jeffmc6767/Autonomous-drone/README.md

JFC,
-
My custom 20x20 drone FC stack for 4s setups, and my custom 3 inch drone frame. 

Screenshot 2026-08-27 at 12 05 02 PM
Screenshot 2026-10-15 at 9 36 35 PM

**FOR THE STARDANCE REVIEWS:** I submitted this a long time ago I dont remember if I said in the note. In my KICAD schematic the wiring is all on the LEFT side. Just zoom out and you can see everything.
Specs:
- 

- up to 99km/h (I calculated based on other drones with similar setup and weight)
- A theoretical 5-7 minutes of flight time though im not sure 
- Costs around 1.2$ a print and tees 3.5 hours. 
- 4K video 60fps (from the dji o4 air unit)
- Usable with Ardu pilot, betafpv, and most other open source software, though I coded one myself(and with the help of AI). Its under the Firmware file
- 44g PLA and PETG print. 

Build guide:
-

Here's how you can start building this yourself:

1. Produce the PCB(like from a pcb manufacturer)
2. Buy all components from the BOM.CSV.
3. Solder all of the components on the PCB(I would recoment using the PCB file because I deleted a lot of the silkscreen text so it would be easier to design)
4. Follow the instructions in the 'Firmware Readme.md' (In the firmware file)
5. Print the drone frame(More about it below)
6. Install the ESC, motors, and solder the connections.
7. Install the FC and solder those connections and connect the ESC to the FC.
8. Install the DJI o4 air unit and also solder or connect the pins and headers. Mount the camera and antennas.
9. If you prefer ELRS you can install that too. I have included the pins. TX, RX, 5.5V, GND
10. Pair with your DJI Goggles and ELRS or DJI controller
11. FLYYY!!

**About the drone frame:**
I have included 3 step files:
1. 1x Top Plate - Top cover for the frame
2. 1x Bottom Plate - The bottom plate
3. 2x TPU Guards - Protects the propellers and motors

Images gallery:
-

Current Version: 
-
**V5.5:** New Drone frame I designed myself: 

It's a 3 inch drone frame that I designed for 1506 motors. It can support a 20x20mm stack and 25.4x25.4 dji o4 air unit. 

It has 4 rubber/tpu things that go around the bottom of the props to protect it. 

In total, it weighs 44g when 3d printed. 
Screenshot 2026-10-15 at 9 28 00 PM

**V5:**
PCB layout:  
The main changes I made was the dimensions from 39mmx37mm to 30mmx32mm. Everything is now compacted and looks much better from the V3 where it was larger and stuff was everywhere. I improved the routing of all of the components and moved every single component to the top of the board that I can use a hot plate and solder everything at once more easily and efficiently. 

- Added ELRS pads for communication
- Added GPS RX and TX
- Added Borometer pads
- Coded the firmware
Screenshot 2026-08-27 at 12 05 02 PM
Screenshot 2026-08-27 at 12 07 03 PM

Screenshot 2026-08-27 at 12 09 32 PM

**Past Versions:**
V4:
-

transferred all B.CU components to the F.CU (not the JST connector) and modified the Edge.cuts 
Screenshot 2026-08-21 at 5 43 20 PM
Screenshot 2026-08-22 at 11 22 32 PM

Screenshot 2026-08-22 at 11 22 59 PM
Screenshot 2026-08-22 at 11 23 20 PM

V3:
-
Screenshot 2026-08-17 at 3 55 34 PM

V2:
-
Screenshot 2026-07-31 at 7 13 25 PM
Screenshot 2026-07-31 at 7 15 06 PM

V1:
- 
Screenshot 2026-07-30 at 10 27 04 PM
