jeffmc6767/Autonomous-drone/CAD/FULL CAD ASSEMBLY.step

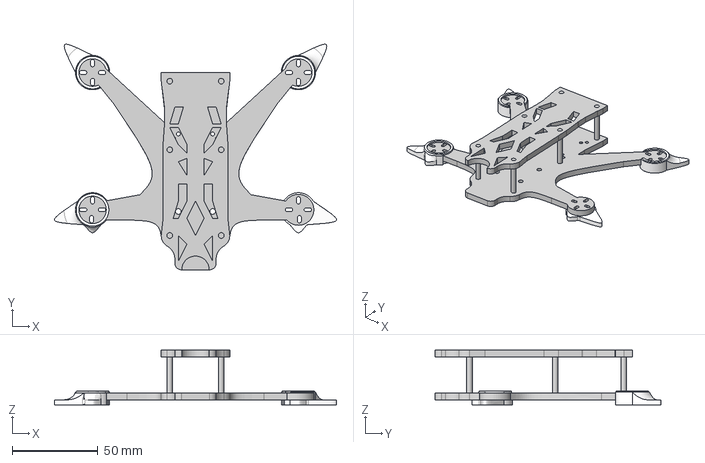
[picture p1: CAD file, 2026-10-16]
CAD/FULL CAD ASSEMBLY.step
164.4 x 131.5 x 32.0 mm
