jeffmc6767/Autonomous-drone/CAD/past versions/Autonomous drone v1.stl

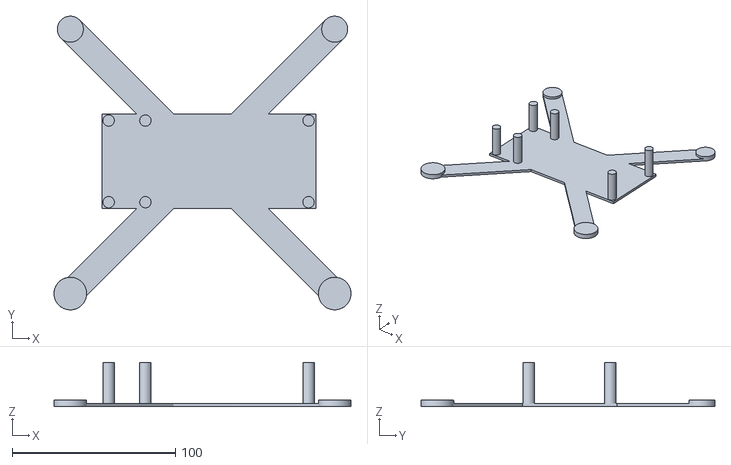
[picture p2: CAD file, 2026-08-21]
CAD/past versions/Autonomous drone v1.stl
182.0 x 180.0 x 27.0
