jeffmc6767/Autonomous-drone/PCB/Schematics and symbols/16-pin-smd-usb-c-connector-through-holes-1/usb-c_16pins_vertical.step

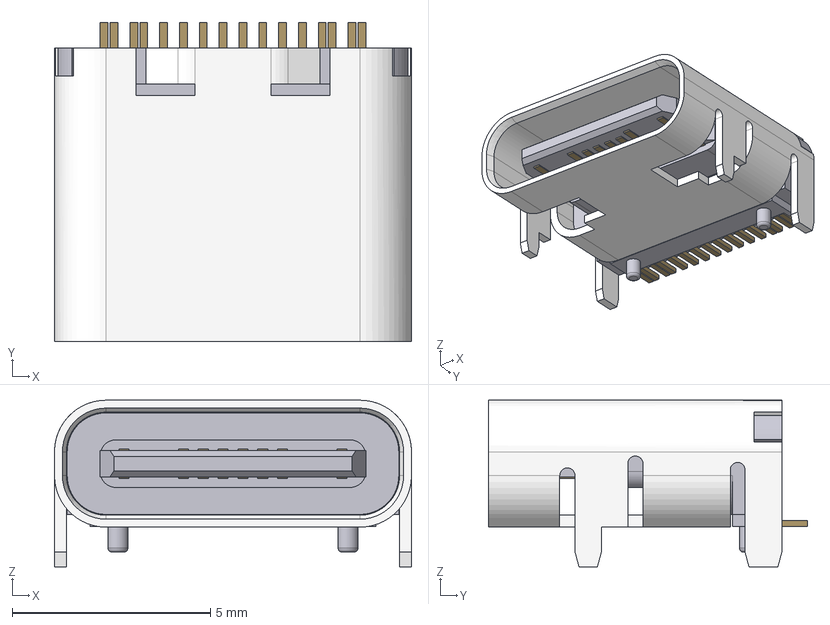
[picture p3: CAD file, 2026-08-21]
PCB/Schematics and symbols/16-pin-smd-usb-c-connector-through-holes-1/usb-c_16pins_vertical.step
9.00 x 8.05 x 4.20 mm
tongue
shield
contact_001
contact_002
contact_003
contact_004
contact_court_001
contact_court_002
contact_court_003
contact_court_004
contact_005
contact_006
contact_007
contact_008
contact_court_005
contact_court_006
contact_court_007
contact_court_008
pin_001
pin_002
pin_003
pin_004
pin_005
pin_006
pin_007
pin_008
pin_009
pin_010
pin_011
pin_012
pin_013
pin_014
pin_015
pin_016
