jeffmc6767/Autonomous-drone/PCB/Schematics and symbols/AON7804/3D/AON7804.stp

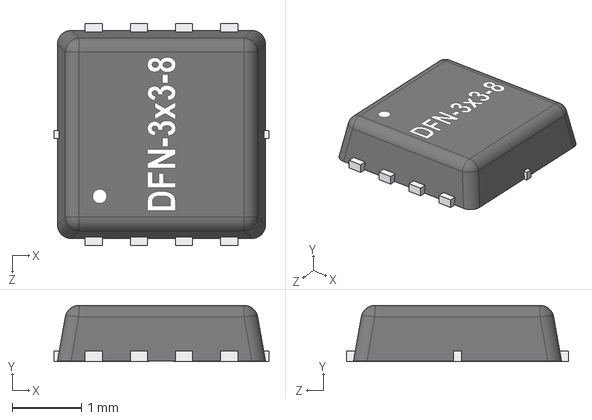
[picture p4: CAD file, 2026-08-21]
PCB/Schematics and symbols/AON7804/3D/AON7804.stp
3.10 x 0.81 x 3.20 mm
lead frame
