jeffmc6767/Autonomous-drone/PCB/Schematics and symbols/LIB_AON7544/AON7544/3D/AON7544.stp

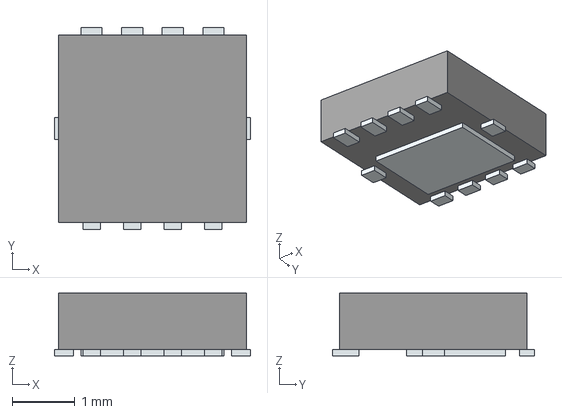
[picture p5: CAD file, 2026-08-21]
PCB/Schematics and symbols/LIB_AON7544/AON7544/3D/AON7544.stp
3.13 x 3.24 x 1.00 mm
Pins
