jeffmc6767/Autonomous-drone/PCB/Schematics and symbols/LIB_AP2127K-3/AP2127K-3.3TRG1/3D/AP2127K-3.3TRG1.stp

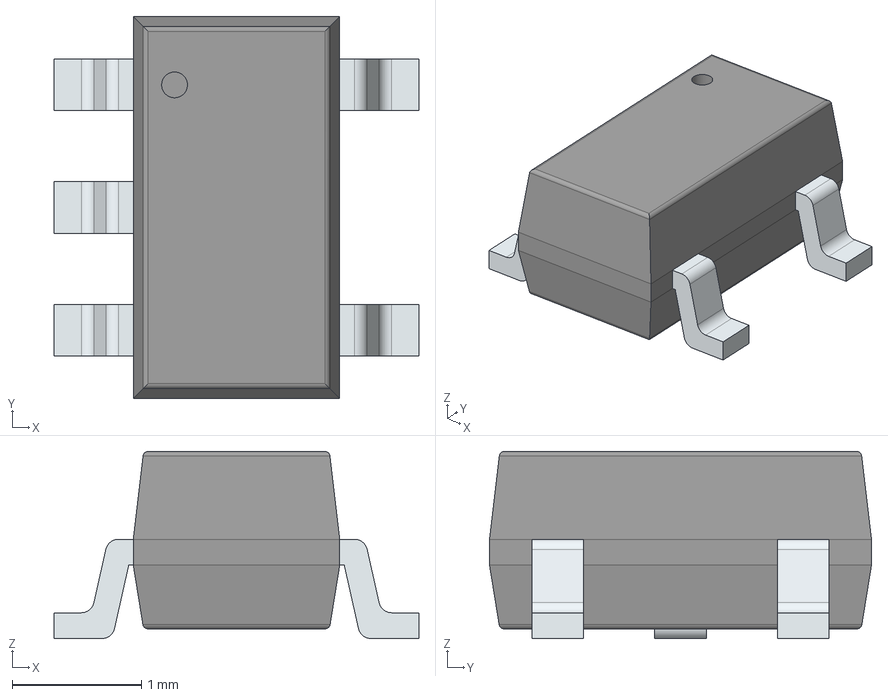
[picture p6: CAD file, 2026-08-21]
PCB/Schematics and symbols/LIB_AP2127K-3/AP2127K-3.3TRG1/3D/AP2127K-3.3TRG1.stp
2.83 x 2.96 x 1.45 mm
PinsArrayL
PinsArrayR
