jeffmc6767/Autonomous-drone/PCB/Schematics and symbols/LIB_BMI270-2/BMI270/3D/BMI270.stp

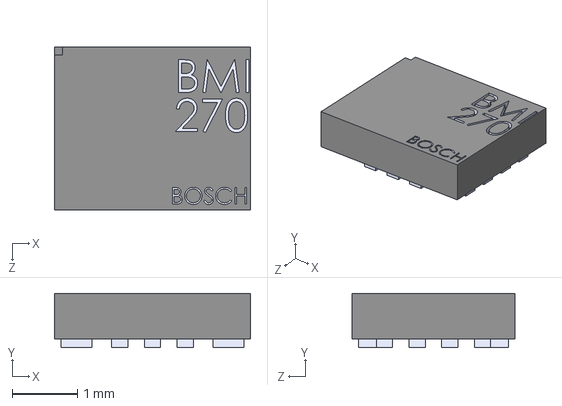
[picture p7: CAD file, 2026-08-21]
PCB/Schematics and symbols/LIB_BMI270-2/BMI270/3D/BMI270.stp
3.00 x 0.83 x 2.50 mm
