jeffmc6767/Autonomous-drone/PCB/Schematics and symbols/LIB_bmp280/bmp280/3D/bmp280.stp

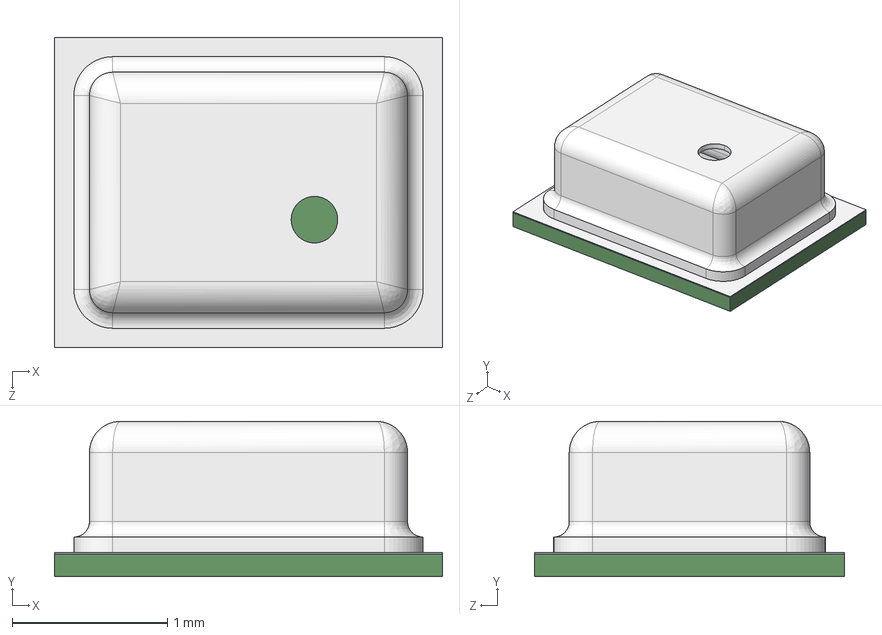
[picture p8: CAD file, 2026-08-21]
PCB/Schematics and symbols/LIB_bmp280/bmp280/3D/bmp280.stp
2.50 x 1.00 x 2.00 mm
