jeffmc6767/Autonomous-drone/PCB/Schematics and symbols/LIB_EFM8BB21F16A-C-QFN20/EFM8BB21F16A-C-QFN20/3D/EFM8BB21F16A-C-QFN20.stp

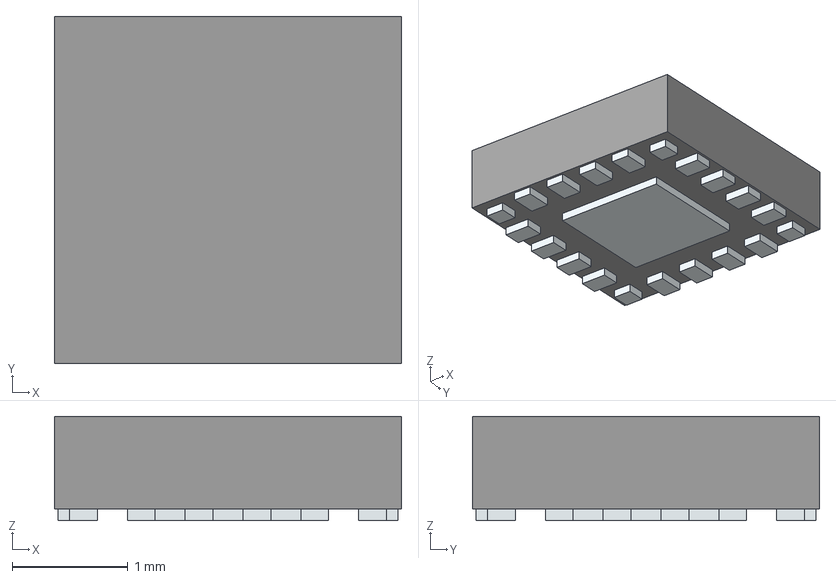
[picture p9: CAD file, 2026-08-21]
PCB/Schematics and symbols/LIB_EFM8BB21F16A-C-QFN20/EFM8BB21F16A-C-QFN20/3D/EFM8BB21F16A-C-QFN20.stp
3.00 x 3.00 x 0.9 mm
Pins
