jeffmc6767/Autonomous-drone/PCB/Schematics and symbols/LIB_FD6288Q/FD6288Q/3D/FD6288Q.stp

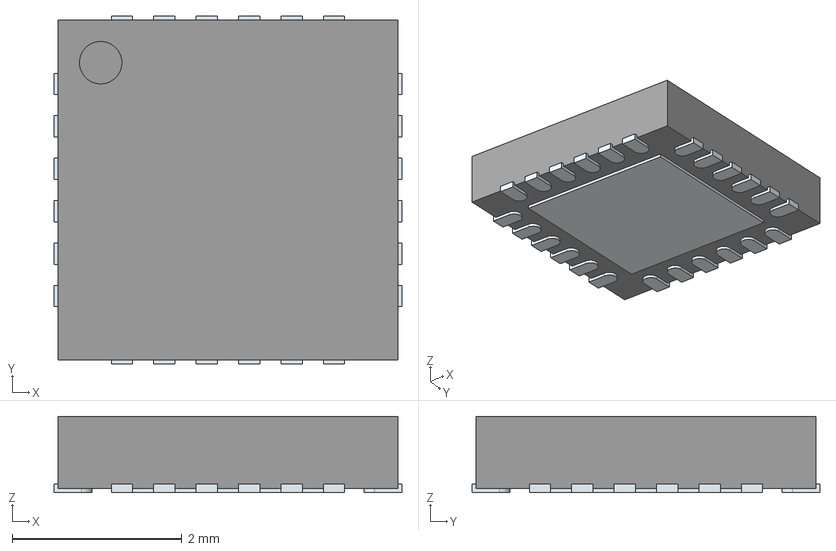
[picture p10: CAD file, 2026-08-21]
PCB/Schematics and symbols/LIB_FD6288Q/FD6288Q/3D/FD6288Q.stp
4.10 x 4.10 x 0.9 mm
ThermalPin
PinsArrayLR
PinsArrayTB
