jeffmc6767/Autonomous-drone/PCB/Schematics and symbols/LIB_FDMC8010/FDMC8010/3D/FDMC8010.stp

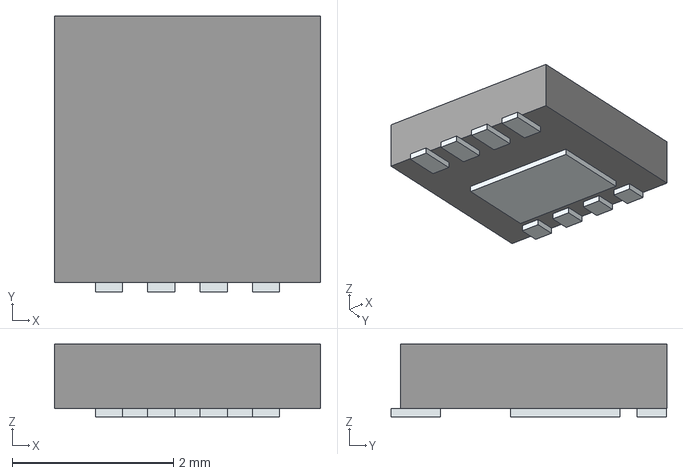
[picture p11: CAD file, 2026-08-21]
PCB/Schematics and symbols/LIB_FDMC8010/FDMC8010/3D/FDMC8010.stp
3.30 x 3.42 x 0.9 mm
Pins
