jeffmc6767/Autonomous-drone/PCB/Schematics and symbols/LIB_MP2359DJ-LF-Z/MP2359DJ-LF-Z/3D/MP2359DJ-LF-Z.stp

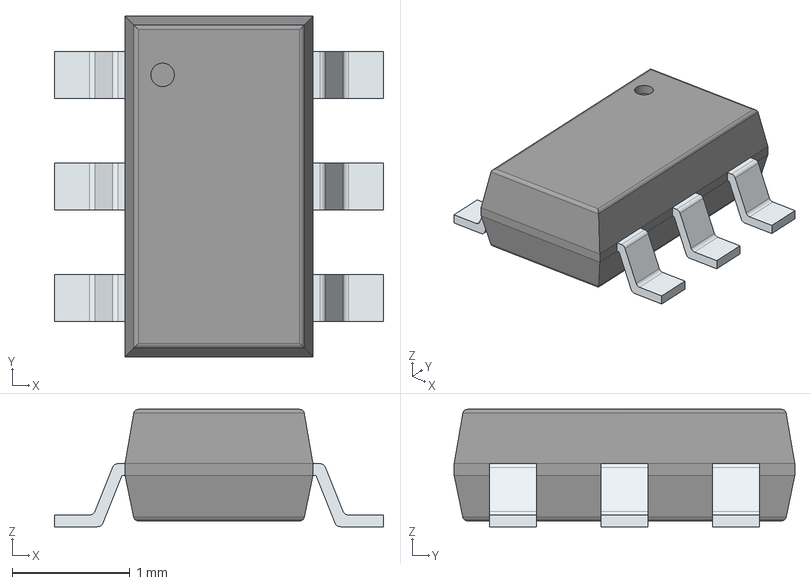
[picture p12: CAD file, 2026-08-21]
PCB/Schematics and symbols/LIB_MP2359DJ-LF-Z/MP2359DJ-LF-Z/3D/MP2359DJ-LF-Z.stp
2.80 x 2.90 x 1.00 mm
PinsArrayLR
