jeffmc6767/Autonomous-drone/PCB/Schematics and symbols/LIB_STM32F411CEU6/STM32F411CEU6/3D/STM32F411CEU6.stp

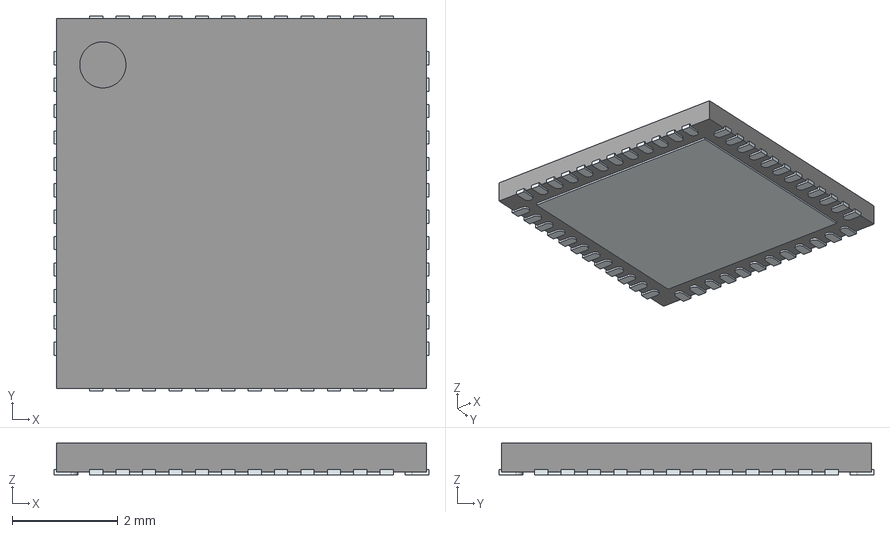
[picture p13: CAD file, 2026-08-21]
PCB/Schematics and symbols/LIB_STM32F411CEU6/STM32F411CEU6/3D/STM32F411CEU6.stp
7.10 x 7.10 x 0.6 mm
ThermalPin
PinsArrayLR
PinsArrayTB
