jeffmc6767/Autonomous-drone/PCB/Schematics and symbols/LIB_STM32G071C8T6/STM32G071C8T6/3D/STM32G071C8T6.stp

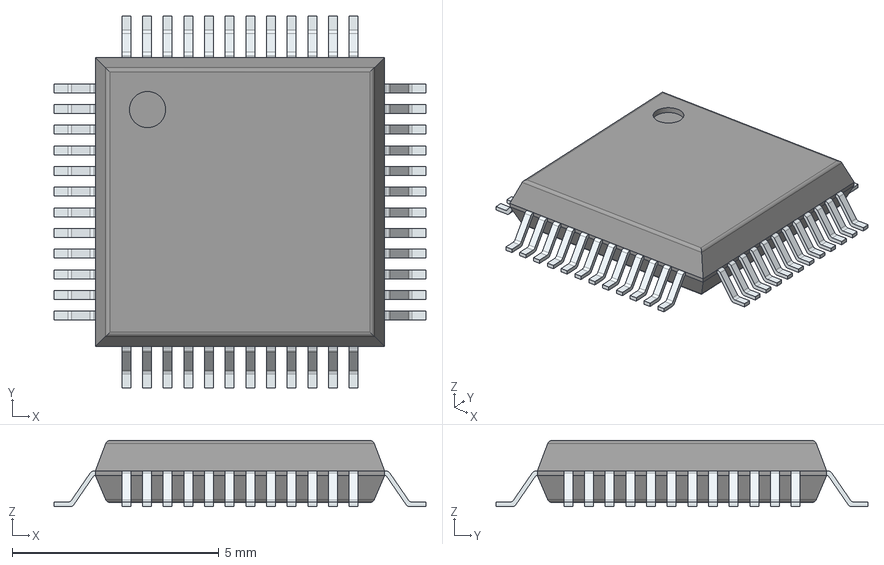
[picture p14: CAD file, 2026-08-21]
PCB/Schematics and symbols/LIB_STM32G071C8T6/STM32G071C8T6/3D/STM32G071C8T6.stp
9.00 x 9.00 x 1.60 mm
PinsArrayLR
PinsArrayTB
