jeffmc6767/Autonomous-drone/PCB/Schematics and symbols/LIB_STM32G071G8U6/STM32G071G8U6/3D/STM32G071G8U6.stp

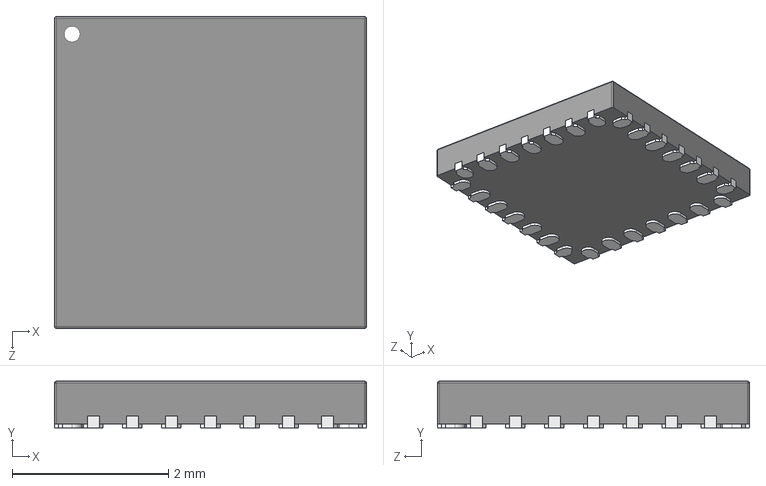
[picture p15: CAD file, 2026-08-21]
PCB/Schematics and symbols/LIB_STM32G071G8U6/STM32G071G8U6/3D/STM32G071G8U6.stp
4.00 x 0.601 x 4.00 mm
