jeffmc6767/Autonomous-drone/Production Files/Autonomous drone frame V3 - 3.5 inch.stl

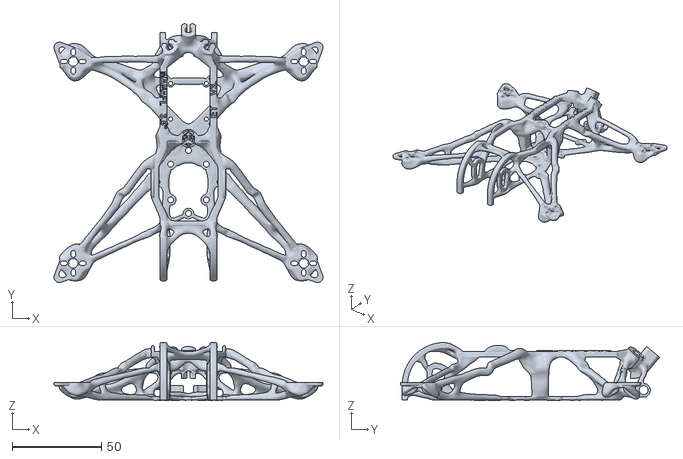
[picture p16: CAD file, 2026-08-21]
Production Files/Autonomous drone frame V3 - 3.5 inch.stl
150.8 x 145.3 x 32.6
