jeffmc6767/Autonomous-drone/CAD/TPU guards.step

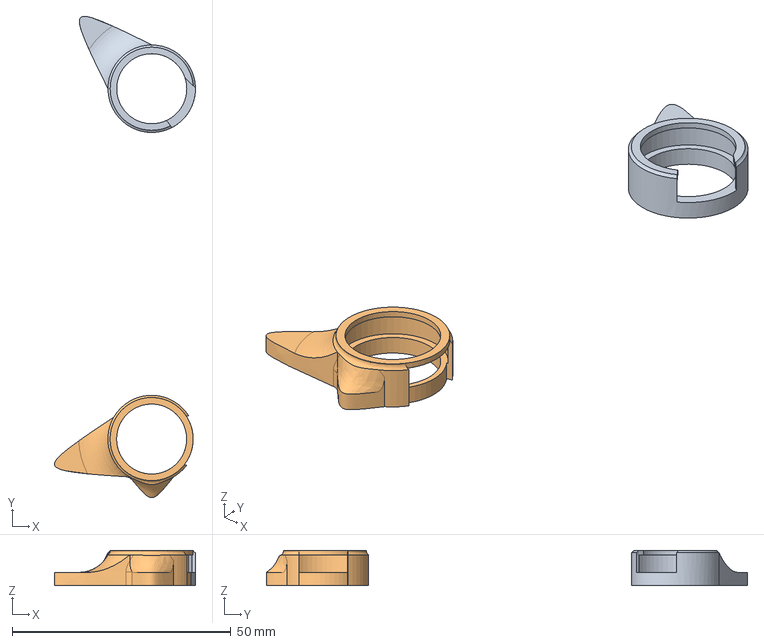
[picture p17: CAD file, 2026-10-16]
CAD/TPU guards.step
32.2 x 110.0 x 8.00 mm
