jeffmc6767/Autonomous-drone/Production Files/TPU 04 unit mounts.stl

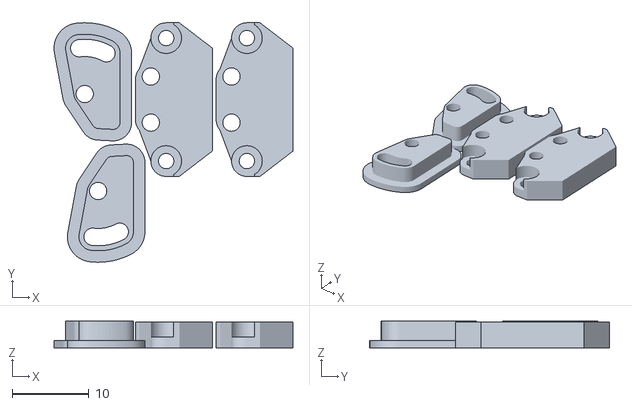
[picture p18: CAD file, 2026-08-21]
Production Files/TPU 04 unit mounts.stl
31.1 x 31.2 x 3.50
