jeffmc6767/Autonomous-drone/CAD/Bottom Plate.step

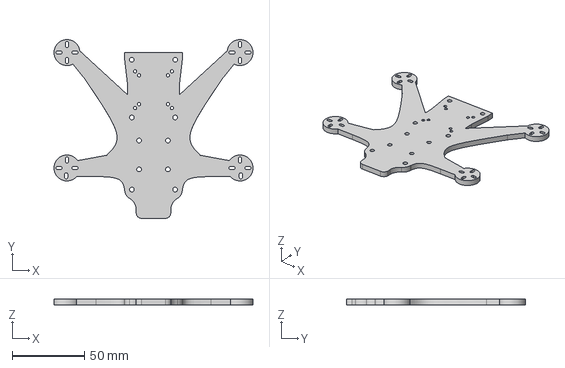
[picture p19: CAD file, 2026-10-16]
CAD/Bottom Plate.step
138.0 x 124.0 x 4.00 mm
