jeffmc6767/Autonomous-drone/CAD/Top Plate.step

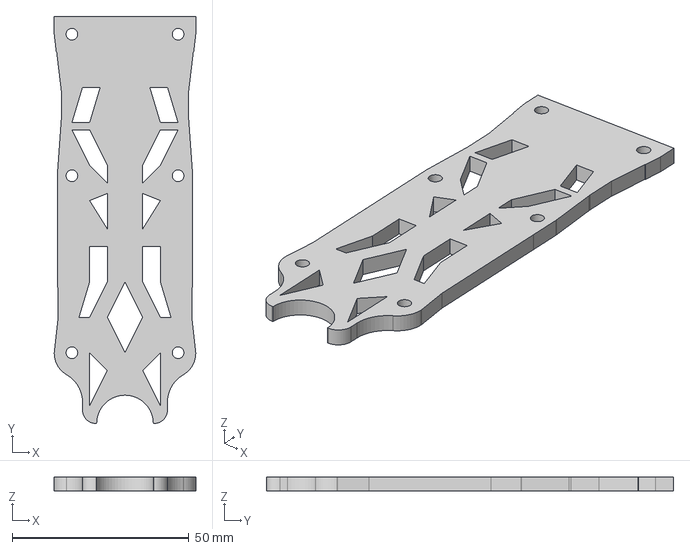
[picture p20: CAD file, 2026-10-16]
CAD/Top Plate.step
40.0 x 115.0 x 4.00 mm
