jeffmc6767/Autonomous-drone/(list of files, cad)

Other CAD files:
CAD/Design file.f3d
PCB/Schematics and symbols/LIB_AON7544/AON7544/Allegro/aon7544.psm
PCB/Schematics and symbols/LIB_AON7544/AON7544/DEHDL/aon7544/chips/chips.prt
PCB/Schematics and symbols/LIB_AP2127K-3/AP2127K-3.3TRG1/Allegro/sot95p282x145-5n.psm
PCB/Schematics and symbols/LIB_AP2127K-3/AP2127K-3.3TRG1/DEHDL/ap2127k_3.3trg1/chips/chips.prt
PCB/Schematics and symbols/LIB_BMI270-2/BMI270/Allegro/bmi270.psm
PCB/Schematics and symbols/LIB_BMI270-2/BMI270/DEHDL/bmi270/chips/chips.prt
PCB/Schematics and symbols/LIB_BMI270/BMI270/Allegro/bmi270.psm
PCB/Schematics and symbols/LIB_BMI270/BMI270/DEHDL/bmi270/chips/chips.prt
PCB/Schematics and symbols/LIB_EFM8BB21F16A-C-QFN20/EFM8BB21F16A-C-QFN20/Allegro/efm8bb21f16acqfn20.psm
PCB/Schematics and symbols/LIB_EFM8BB21F16A-C-QFN20/EFM8BB21F16A-C-QFN20/DEHDL/efm8bb21f16a_c_qfn20/chips/chips.prt
PCB/Schematics and symbols/LIB_FD6288Q/FD6288Q/Allegro/qfn50p400x400x90-25n-d.psm
PCB/Schematics and symbols/LIB_FD6288Q/FD6288Q/DEHDL/fd6288q/chips/chips.prt
PCB/Schematics and symbols/LIB_FDMC8010/FDMC8010/Allegro/fdmc8010.psm
PCB/Schematics and symbols/LIB_FDMC8010/FDMC8010/DEHDL/fdmc8010/chips/chips.prt
PCB/Schematics and symbols/LIB_MP2359DJ-LF-Z/MP2359DJ-LF-Z/Allegro/sot95p280x100-6n.psm
PCB/Schematics and symbols/LIB_MP2359DJ-LF-Z/MP2359DJ-LF-Z/DEHDL/mp2359dj_lf_z/chips/chips.prt
PCB/Schematics and symbols/LIB_STM32F411CEU6/STM32F411CEU6/Allegro/qfn50p700x700x60-49n-d.psm
PCB/Schematics and symbols/LIB_STM32F411CEU6/STM32F411CEU6/DEHDL/stm32f411ceu6/chips/chips.prt
PCB/Schematics and symbols/LIB_STM32G071C8T6/STM32G071C8T6/Allegro/qfp50p900x900x160-48n.psm
PCB/Schematics and symbols/LIB_STM32G071C8T6/STM32G071C8T6/DEHDL/stm32g071c8t6/chips/chips.prt
PCB/Schematics and symbols/LIB_STM32G071G8U6/STM32G071G8U6/Allegro/qfn50p400x400x60-28n-d.psm
PCB/Schematics and symbols/LIB_STM32G071G8U6/STM32G071G8U6/DEHDL/stm32g071g8u6/chips/chips.prt
PCB/Schematics and symbols/LIB_TPC8107/TPC8107/Allegro/soic127p600x190-8n.psm
PCB/Schematics and symbols/LIB_TPC8107/TPC8107/DEHDL/tpc8107/chips/chips.prt
PCB/Schematics and symbols/LIB_bmp280/bmp280/Allegro/8-pin-metal-lid-lga.psm
PCB/Schematics and symbols/LIB_bmp280/bmp280/DEHDL/bmp280/chips/chips.prt
