jeffmc6767/Autonomous-drone/(list of files, drawings)

Other design files:
PCB/Schematics and symbols/LIB_AP2127K-3/AP2127K-3.3TRG1/Altium/AP2127K-3.3TRG1.SchLib
PCB/Schematics and symbols/LIB_AP2127K-3/AP2127K-3.3TRG1/Altium/SOT95P282X145-5N.PcbLib
PCB/Schematics and symbols/LIB_BMI270-2/BMI270/Altium/BMI270.PcbLib
PCB/Schematics and symbols/LIB_BMI270-2/BMI270/Altium/BMI270.SchLib
PCB/Schematics and symbols/LIB_BMI270/BMI270/Altium/BMI270.PcbLib
PCB/Schematics and symbols/LIB_BMI270/BMI270/Altium/BMI270.SchLib
PCB/Schematics and symbols/LIB_EFM8BB21F16A-C-QFN20/EFM8BB21F16A-C-QFN20/Altium/EFM8BB21F16A-C-QFN20.SchLib
PCB/Schematics and symbols/LIB_EFM8BB21F16A-C-QFN20/EFM8BB21F16A-C-QFN20/Altium/EFM8BB21F16ACQFN20.PcbLib
PCB/Schematics and symbols/LIB_FD6288Q/FD6288Q/Altium/FD6288Q.SchLib
PCB/Schematics and symbols/LIB_FD6288Q/FD6288Q/Altium/QFN50P400X400X90-25N-D.PcbLib
PCB/Schematics and symbols/LIB_FDMC8010/FDMC8010/Altium/FDMC8010.PcbLib
PCB/Schematics and symbols/LIB_FDMC8010/FDMC8010/Altium/FDMC8010.SchLib
PCB/Schematics and symbols/LIB_MP2359DJ-LF-Z/MP2359DJ-LF-Z/Altium/MP2359DJ-LF-Z.SchLib
PCB/Schematics and symbols/LIB_MP2359DJ-LF-Z/MP2359DJ-LF-Z/Altium/SOT95P280X100-6N.PcbLib
PCB/Schematics and symbols/LIB_STM32F411CEU6/STM32F411CEU6/Altium/QFN50P700X700X60-49N-D.PcbLib
PCB/Schematics and symbols/LIB_STM32F411CEU6/STM32F411CEU6/Altium/STM32F411CEU6.SchLib
PCB/Schematics and symbols/LIB_STM32G071C8T6/STM32G071C8T6/Altium/QFP50P900X900X160-48N.PcbLib
PCB/Schematics and symbols/LIB_STM32G071C8T6/STM32G071C8T6/Altium/STM32G071C8T6.SchLib
PCB/Schematics and symbols/LIB_STM32G071G8U6/STM32G071G8U6/Altium/QFN50P400X400X60-28N-D.PcbLib
PCB/Schematics and symbols/LIB_STM32G071G8U6/STM32G071G8U6/Altium/STM32G071G8U6.SchLib
PCB/Schematics and symbols/LIB_TPC8107/TPC8107/Altium/SOIC127P600X190-8N.PcbLib
PCB/Schematics and symbols/LIB_TPC8107/TPC8107/Altium/TPC8107.SchLib
