jeffmc6767/Autonomous-drone/PCB/FCPCB.kicad_pcb

## KiCad design PCB/FCPCB.kicad_pcb (2026-08-21)

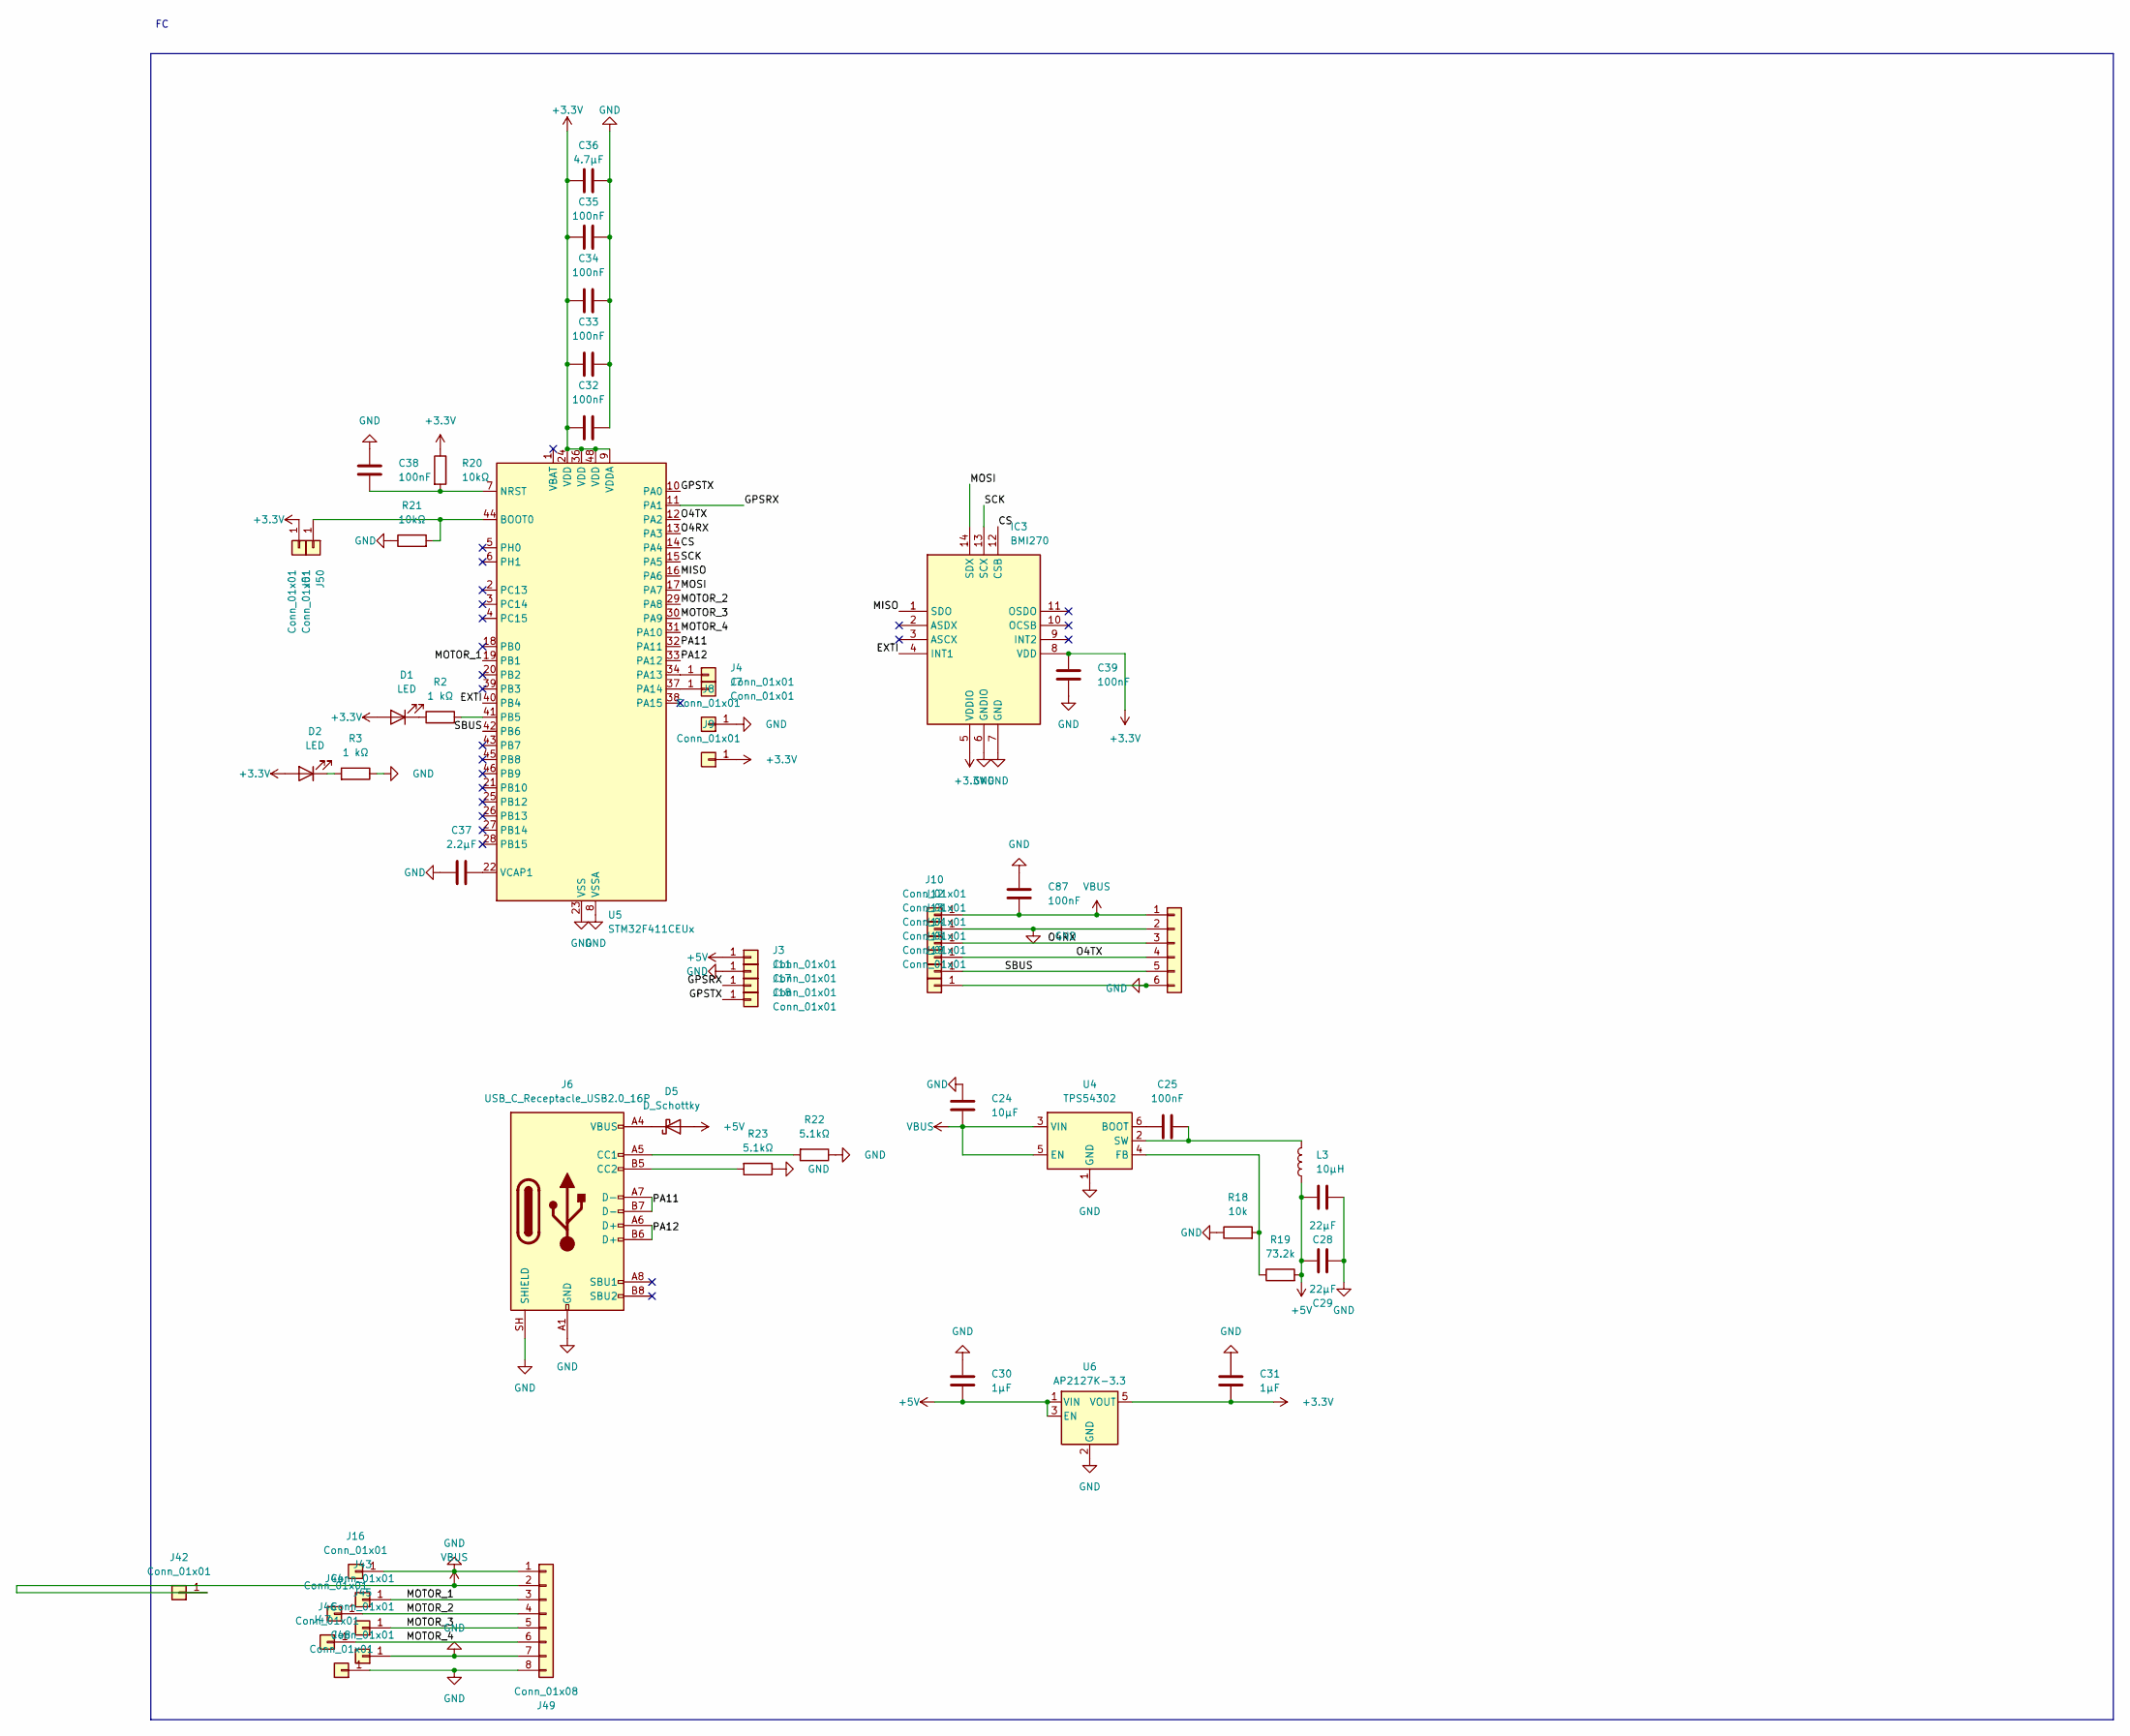
[picture p21: schematic FCPCB.kicad_sch]

Parts:
C24: 10µF; C_0402_1005Metric_Pad0.74x0.62mm_HandSolder
C25, C32, C33, C34, C35, C38, C39, C87: 100nF; C_0402_1005Metric_Pad0.74x0.62mm_HandSolder
C28: 22µF; C_0402_1005Metric_Pad0.74x0.62mm_HandSolder
C29: 22µF; C_0805_2012Metric_Pad1.18x1.45mm_HandSolder
C30, C31: 1µF; C_0402_1005Metric_Pad0.74x0.62mm_HandSolder
C36: 4.7µF; C_0402_1005Metric_Pad0.74x0.62mm_HandSolder
C37: 2.2µF; C_0402_1005Metric_Pad0.74x0.62mm_HandSolder
D1, D2: LED; LED_0603_1608Metric_Pad1.05x0.95mm_HandSolder
D5: D_Schottky; D_SOD-123
IC3: BMI270; Manufacturer_Part_Number BMI270; Mouser Part Number 262-BMI270
J3, J4, J7, J8, J9, J10, J11, J12, J13, J14, J15, J16, J17, J18, J19, J42, J43, J44, J45, J46, J47, J48, J50, J51: Conn_01x01; TestPoint_Pad_1.0x1.0mm
J5: Conn_01x06; JST_SH_SM06B-SRSS-TB_1x06-1MP_P1.00mm_Horizontal
J6: USB_C_Receptacle_USB2.0_16P; USB_C_Receptacle_HRO_TYPE-C-31-M-12
J49: Conn_01x08; JST_SH_SM08B-SRSS-TB_1x08-1MP_P1.00mm_Horizontal
L3: 10μH; L_Coilcraft_XAL4020-XXX
R2, R3: 1 kΩ; R_0402_1005Metric_Pad0.72x0.64mm_HandSolder
R18: 10k; R_0402_1005Metric_Pad0.72x0.64mm_HandSolder
R19: 73.2k; R_0402_1005Metric_Pad0.72x0.64mm_HandSolder
R20, R21: 10kΩ; R_0402_1005Metric_Pad0.72x0.64mm_HandSolder
R22, R23: 5.1kΩ; R_0402_1005Metric_Pad0.72x0.64mm_HandSolder
U4: TPS54302; SOT-23-6
U5: STM32F411CEUx; QFN-48-1EP_7x7mm_P0.5mm_EP5.6x5.6mm
U6: AP2127K-3.3; SOT-23-5

Connections:
+3.3V: C31.2, C32.1, C33.1, C34.1, C35.1, C36.1, C39.1, D1.2 (A), D2.2 (A), IC3.5 (VDDIO), IC3.8 (VDD), J9.1 (Pin_1_1), J51.1 (Pin_1_1), R20.1, U5.9 (VDDA), U5.24 (VDD), U5.36 (VDD), U5.48 (VDD), U6.5 (VOUT)
+5V: C28.2, C29.2, C30.2, D5.2 (A), J3.1 (Pin_1_1), L3.1, R19.2, U6.1 (VIN), U6.3 (EN)
/CS: IC3.12 (CSB), U5.14 (PA4)
/EXTI: IC3.4 (INT1), U5.40 (PB4)
/GPSRX: J17.1 (Pin_1_1), U5.11 (PA1)
/GPSTX: J18.1 (Pin_1_1), U5.10 (PA0)
/MISO: IC3.1 (SDO), U5.16 (PA6)
/MOSI: IC3.14 (SDX), U5.17 (PA7)
/MOTOR_1: J43.1 (Pin_1_1), J49.3, U5.19 (PB1)
/MOTOR_2: J44.1 (Pin_1_1), J49.4, U5.29 (PA8)
/MOTOR_3: J45.1 (Pin_1_1), J49.5, U5.30 (PA9)
/MOTOR_4: J46.1 (Pin_1_1), J49.6, U5.31 (PA10)
/O4RX: J5.3, J13.1 (Pin_1_1), U5.13 (PA3)
/O4TX: J5.4, J14.1 (Pin_1_1), U5.12 (PA2)
/PA11: J6.A7 (D-), J6.B7 (D-), U5.32 (PA11)
/PA12: J6.A6 (D+), J6.B6 (D+), U5.33 (PA12)
/SBUS: J5.5, J15.1 (Pin_1_1), U5.42 (PB6)
/SCK: IC3.13 (SCX), U5.15 (PA5)
GND: C24.1, C28.1, C29.1, C30.1, C31.1, C32.2, C33.2, C34.2, C35.2, C36.2, C37.1, C38.1, C39.2, C87.1, IC3.6 (GNDIO), IC3.7 (GND), J5.2, J5.6, J6.A1 (GND), J6.A12 (GND), J6.B1 (GND), J6.B12 (GND), J6.SH (SHIELD), J8.1 (Pin_1_1), J11.1 (Pin_1_1), J12.1 (Pin_1_1), J16.1 (Pin_1_1), J19.1 (Pin_1_1), J47.1 (Pin_1_1), J48.1 (Pin_1_1), J49.1, J49.7, J49.8, R3.1, R18.1, R21.1, R22.1, R23.1, U4.1 (GND), U5.8 (VSSA), U5.23 (VSS), U5.35 (VSS), U5.47 (VSS), U5.49 (VSS), U6.2 (GND)
unnamed: D1.1 (K), R2.1
unnamed: D2.1 (K), R3.2
unnamed: D5.1 (K), J6.A4 (VBUS), J6.A9 (VBUS), J6.B4 (VBUS), J6.B9 (VBUS)
unnamed: J4.1 (Pin_1_1), U5.34 (PA13)
unnamed: J6.A5 (CC1), R22.2
unnamed: J6.B5 (CC2), R23.2
unnamed: J7.1 (Pin_1_1), U5.37 (PA14)
unnamed: J50.1 (Pin_1_1), R21.2, U5.44 (BOOT0)
unnamed: C25.2, U4.6 (BOOT)
unnamed: R18.2, R19.1, U4.4 (FB)
unnamed: C25.1, L3.2, U4.2 (SW)
unnamed: C38.2, R20.2, U5.7 (NRST)
unnamed: R2.2, U5.41 (PB5)
unnamed: C37.2, U5.22 (VCAP1)
VBUS: C24.2, C87.2, J5.1, J10.1 (Pin_1_1), J42.1 (Pin_1_1), J49.2, U4.3 (VIN), U4.5 (EN)

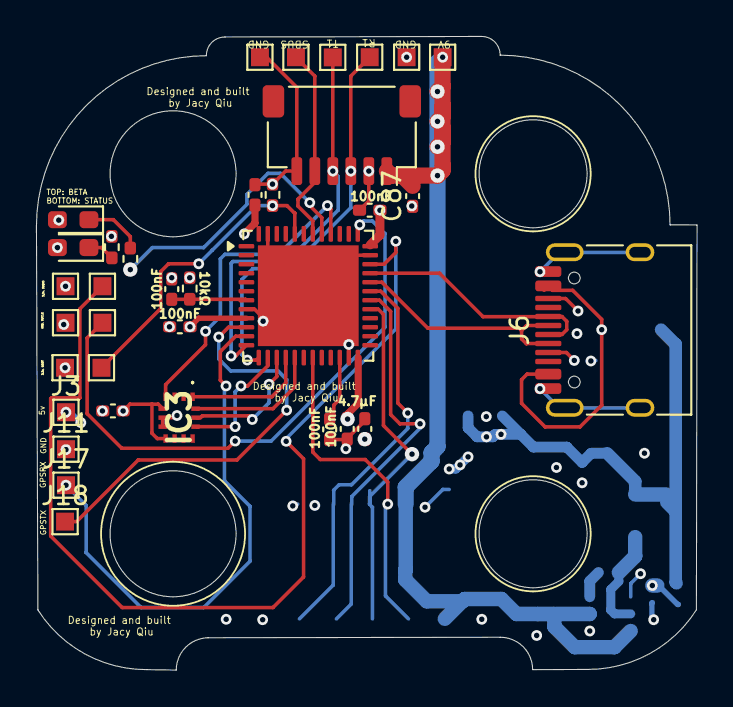
[picture p22: board FCPCB.kicad_pcb from above]

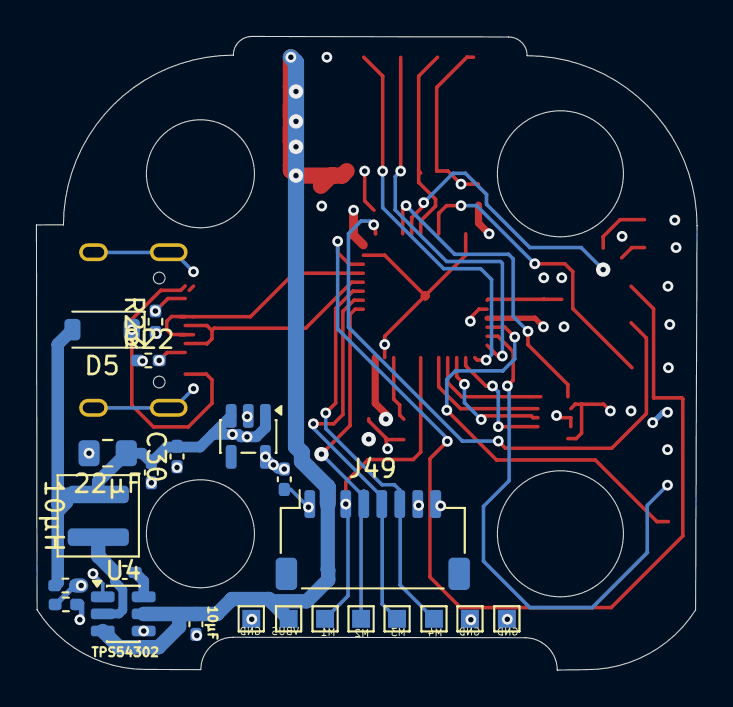
[picture p23: board FCPCB.kicad_pcb from below]

Board: 4 copper layers, 36.7 x 35.2 mm, 58 parts (23 on the bottom side), 34 nets.
