jeffmc6767/Autonomous-drone/(commit log)

2026-08-21 Initial commit of drone project
    [8-pin-metal-lid-lga.psm, AON7544.stp, AON7804.stp, AP2127K-3.3TRG1.SchLib, AP2127K-3.3TRG1.stp, Autonomous drone frame V3 - 3.5 inch.stl, Autonomous drone v1.stl, BMI270.PcbLib]
2026-08-21 Update README with new images and PCB details
    Added additional images and comments about the drone's PCB and frame modifications.
2026-08-27 Update README with V5 and V4 PCB changes
    Added new features and updates for V5 and V4 of the PCB layout.
2026-08-29 file location
    [Autonomous drone v1.stl]
2026-10-16 Add firmware readme for STM32F411CEU6
    Added detailed instructions for compiling and flashing the STM32F411CEU6 flight controller firmware, including prerequisites and commands.
2026-10-16 Update README with correct drone FC stack specs
    Updated the description of the drone FC stack to reflect support for 4s setups instead of 3-4s. Removed outdated information about the 2 inch drone frame.
